NKDIA3/Huhnerklappe/Doku/Rückseite 1.jpg

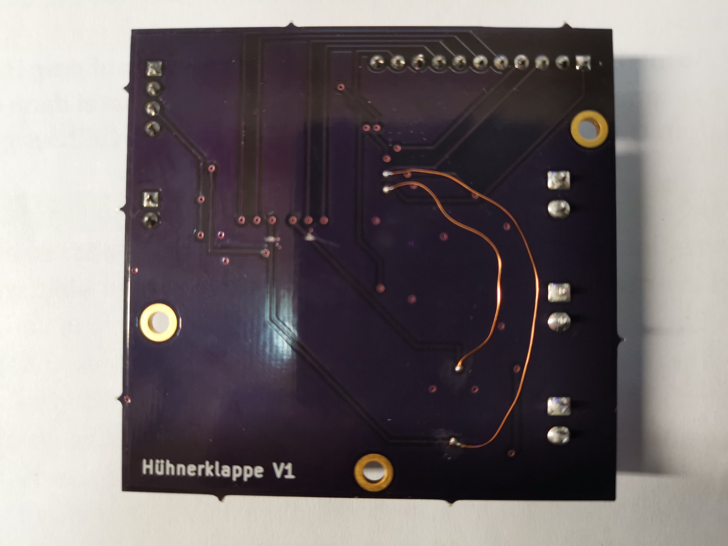
Doku/Rückseite 1.jpg
