NKDIA3/Huhnerklappe/Abschluss/Bilder/Rück layout.png

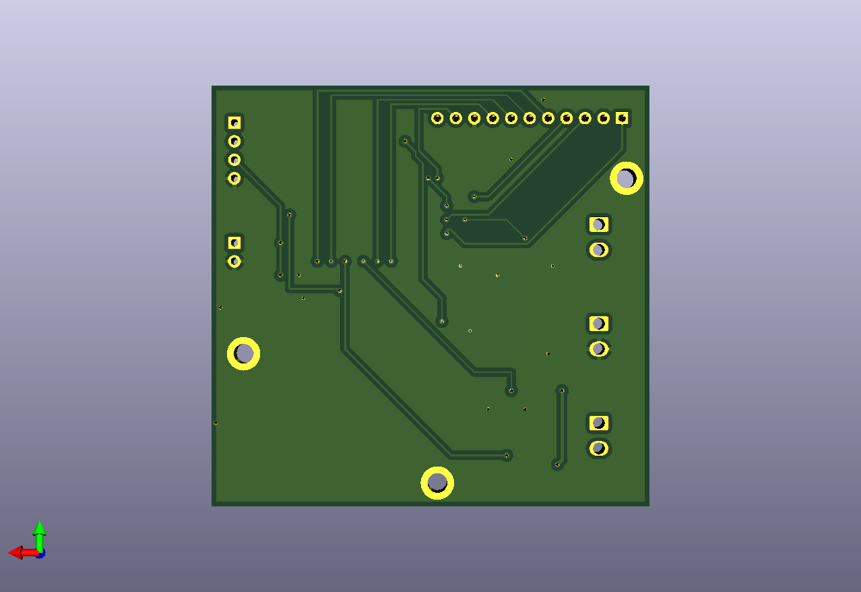
Abschluss/Bilder/Rück layout.png
