NKDIA3/Huhnerklappe/Abschluss/Bilder/Front layout.png

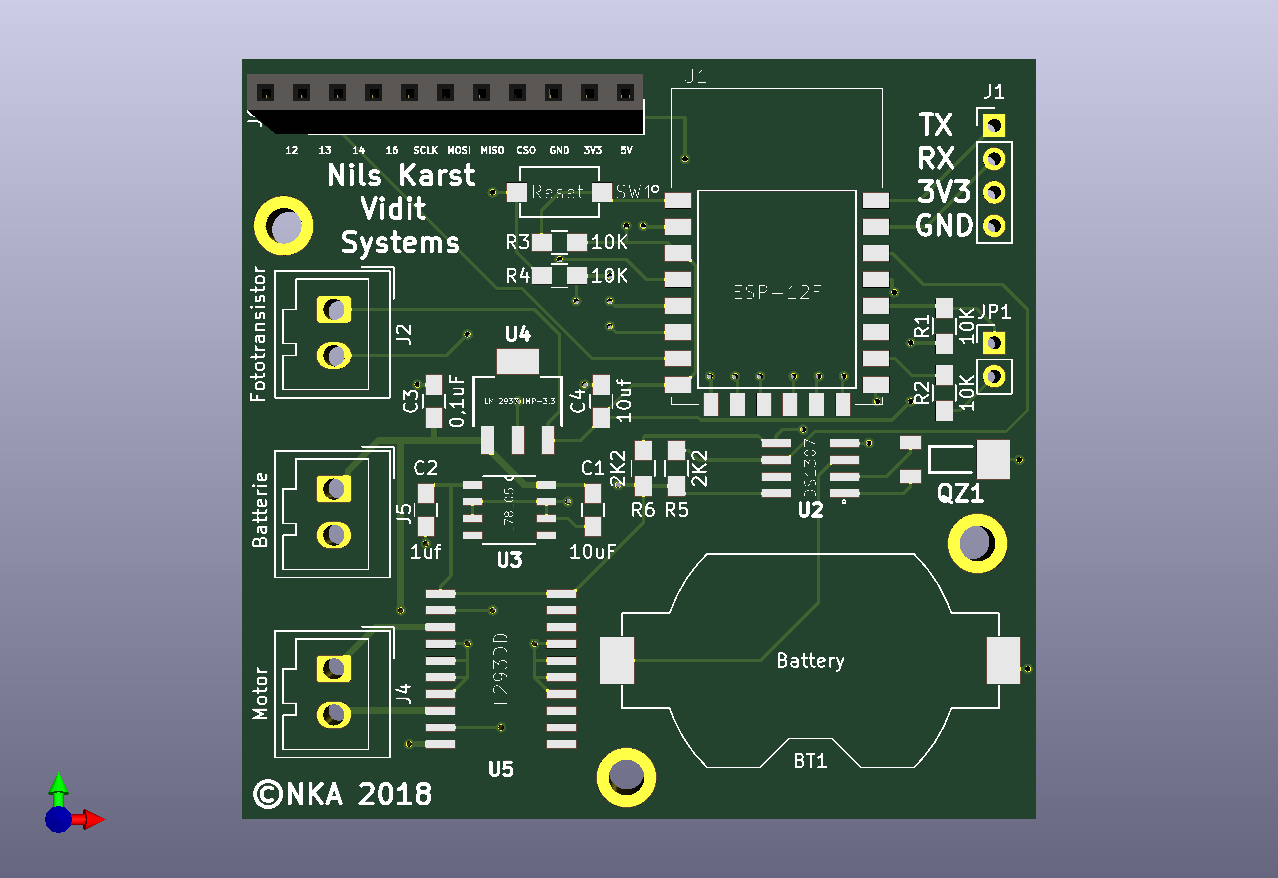
Abschluss/Bilder/Front layout.png
