NKDIA3/Huhnerklappe/Abschluss/Bilder/Frontlayout.png

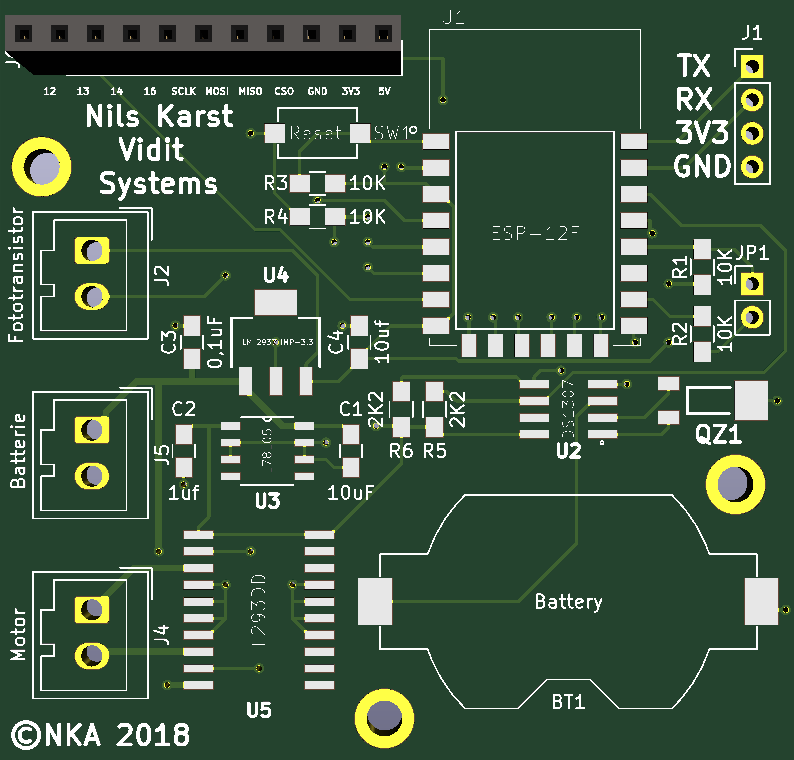
Abschluss/Bilder/Frontlayout.png
