NKDIA3/Huhnerklappe/Abschluss/Bilder/Rücklayout.png

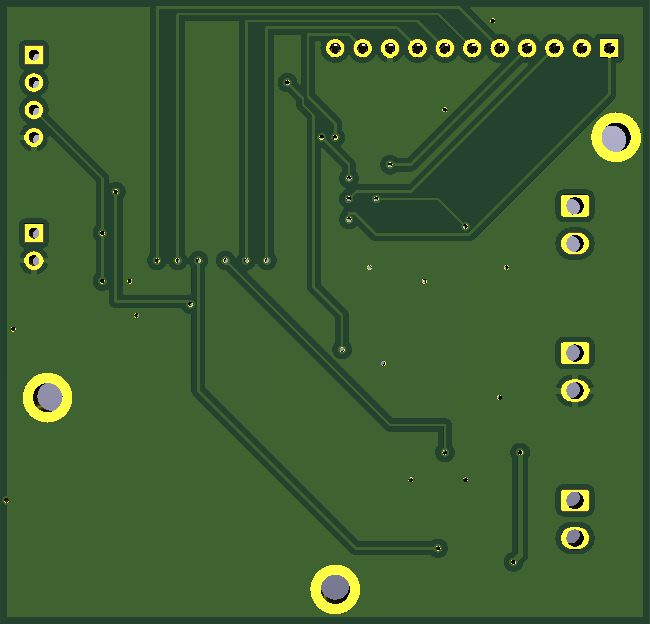
Abschluss/Bilder/Rücklayout.png
