NKDIA3/Huhnerklappe/Doku/Rückseite 2.jpg

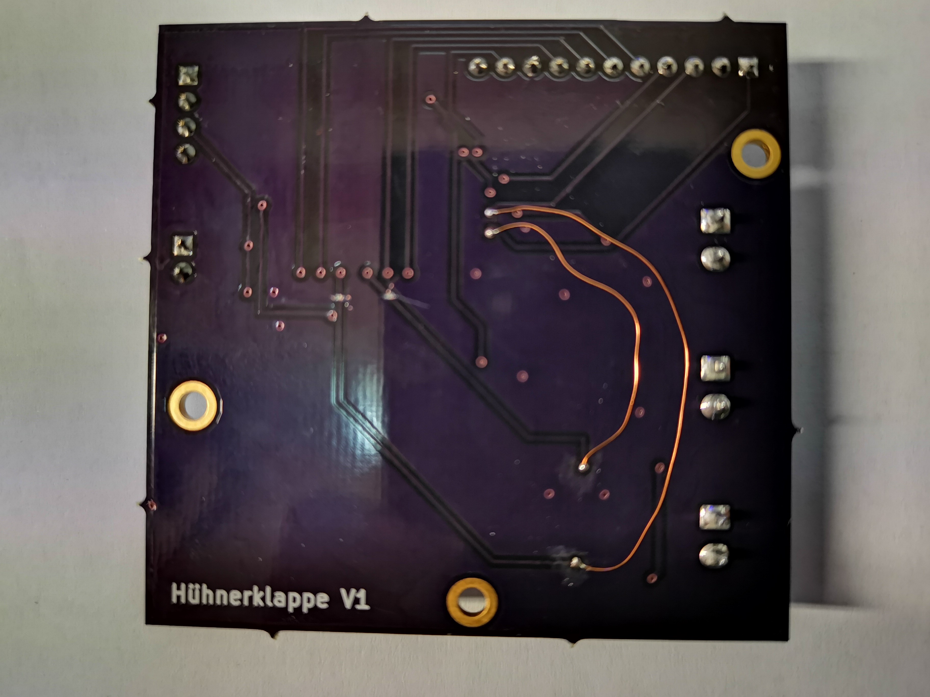
Doku/Rückseite 2.jpg
