NKDIA3/Huhnerklappe/Doku/Rückseite.png

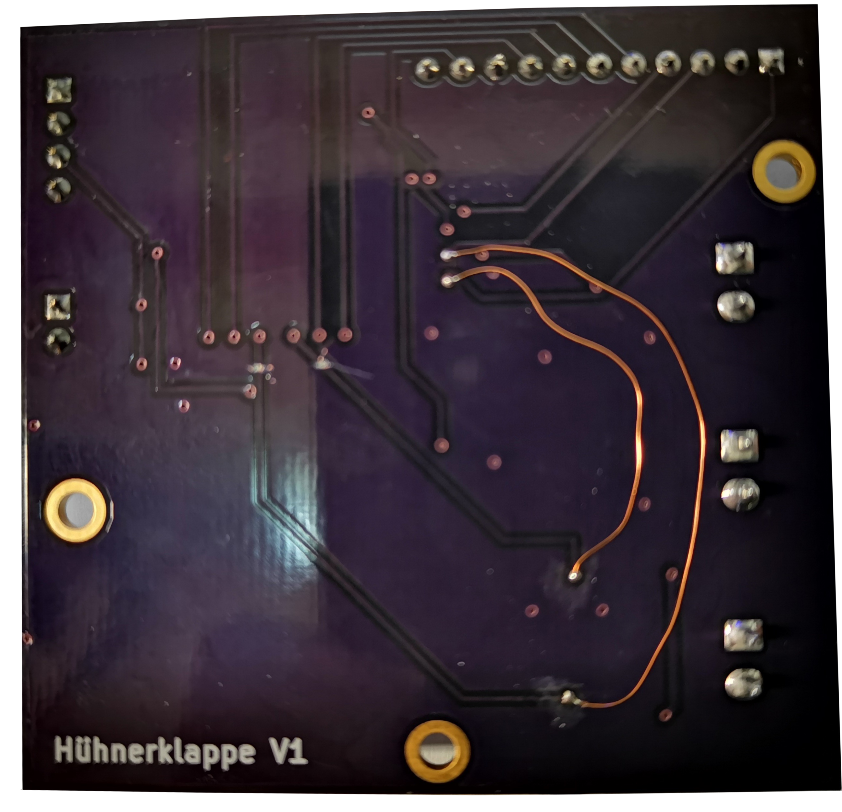
Doku/Rückseite.png
