NKDIA3/Huhnerklappe/Doku/Schaltplan.png

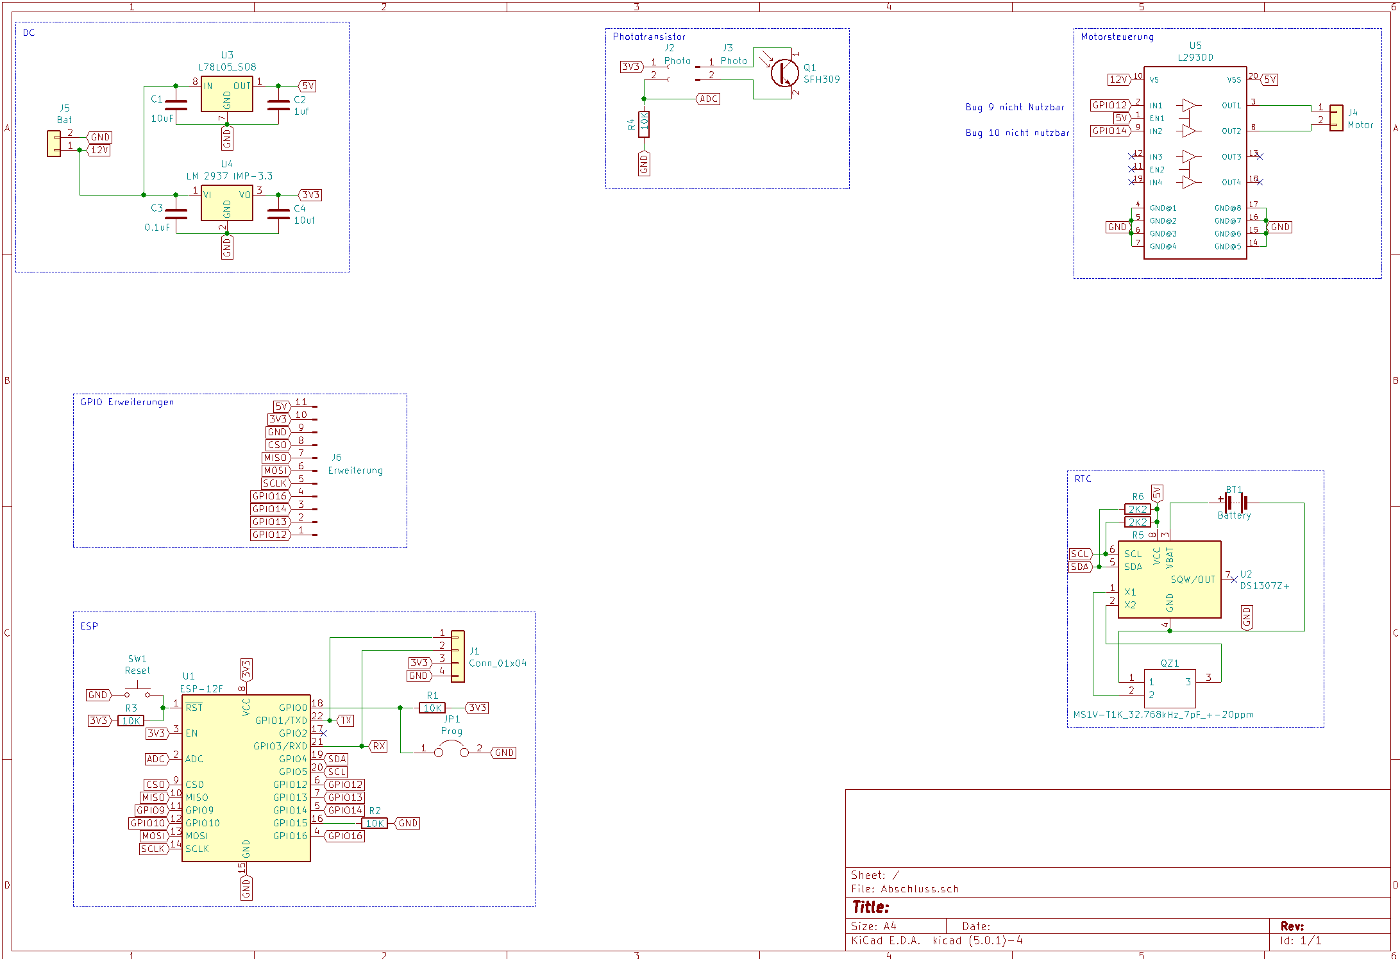
Doku/Schaltplan.png
