NKDIA3/Huhnerklappe/Doku/SchaltplanA3.png

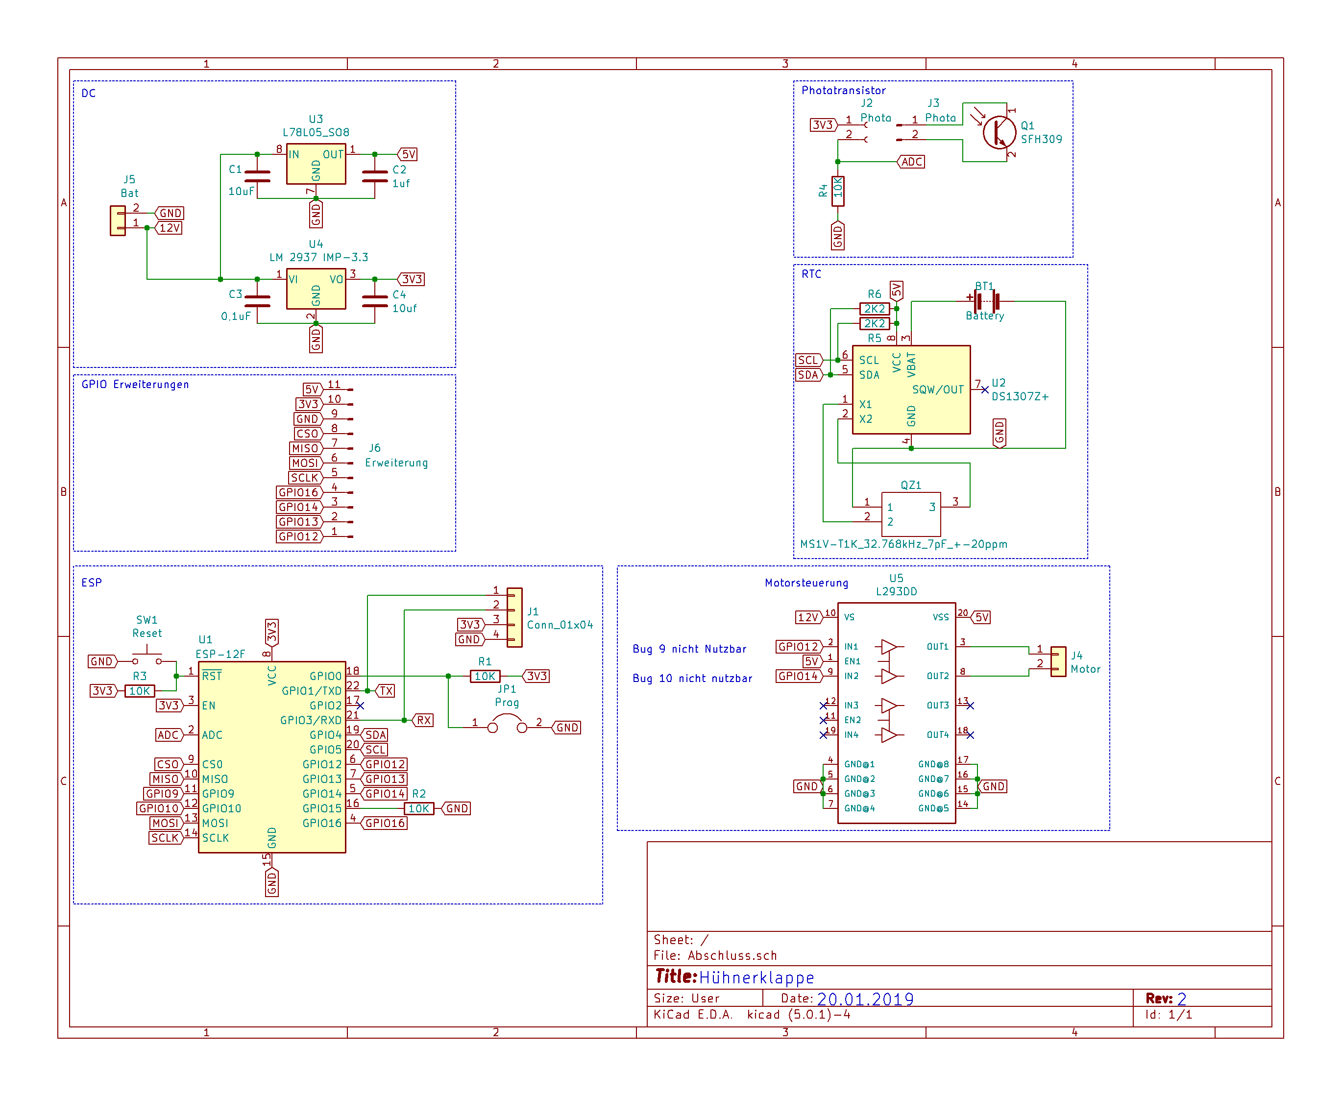
Doku/SchaltplanA3.png
