NKDIA3/Huhnerklappe/Doku/Vorderseite 2.jpg

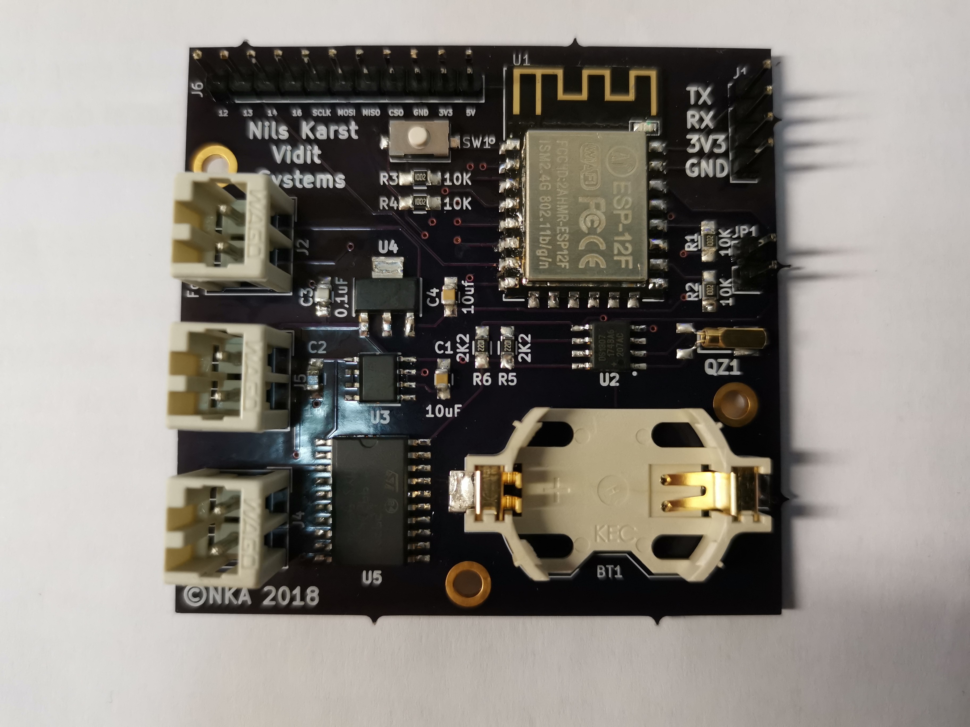
Doku/Vorderseite 2.jpg
