NKDIA3/Huhnerklappe/Abschluss/arduino_micro_shield-master/Schule/Stückliste Binary Clock.xlsx

Stückliste Binary Clock
Pos | Bezeichnung | Typ | Stückz. | Lieferant | Bestellnummer
1 | Bat1 | Batterie | 1 | Farnell | 1823483
2 | U2 | RTC | 1 | Farnell | 2515369
3 | Qz1 | Quarz | 1 | Farnell | 1539359
4 | R1,R2 | 2K2 | 2 | Farnell | 2502700
5 | R3-19 | LED Vorwiderstand 120r | 17 | Farnell | 9339884
6 | D1-6 | LED_Rot | 6 | Reichelt | V 320
7 | D7-17 | LED_Gelb | 11 | Reichelt | V 323
8 | U1 | Arduino | 1 | Reichelt | ARDUINO MICRO
