NKDIA3/Huhnerklappe/TODO Vidit Dienstag.txt

Platine löten 
Bilder 
In Doku 
Doku drucken und abheften
Datenblätter drucken
