NKDIA3/Huhnerklappe/Abschluss/arduino_micro_shield-master/Schule - Kopie/Schaltplanm.pdf

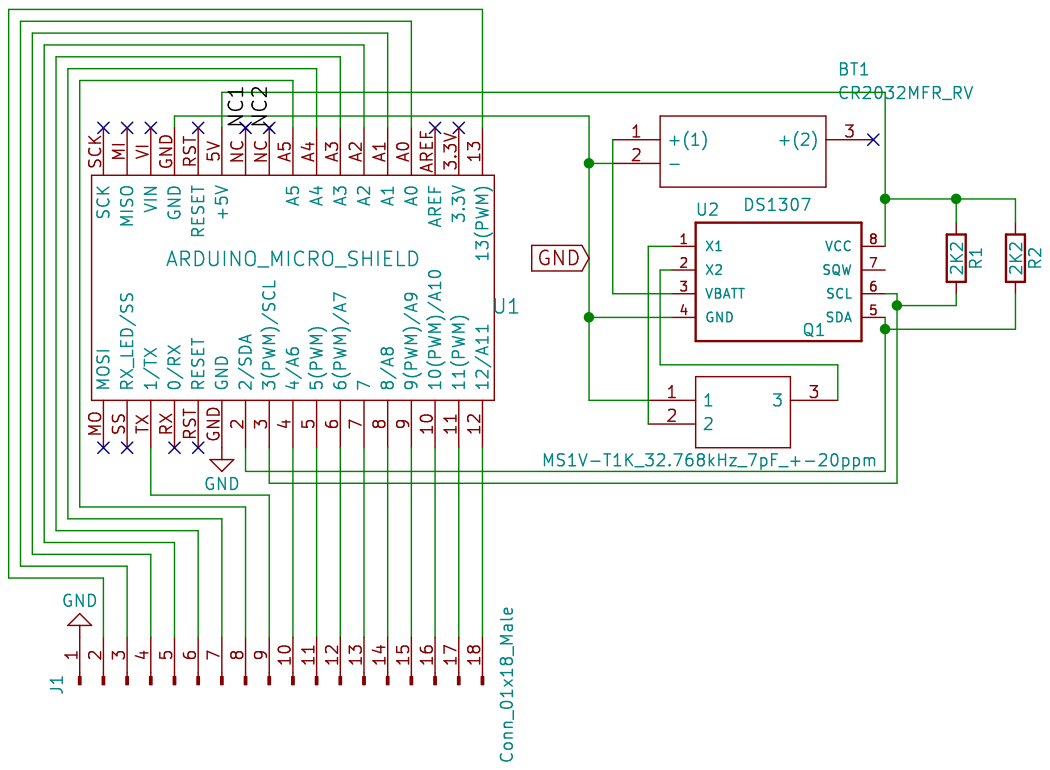
[picture p26: page 1]
