NKDIA3/Huhnerklappe/(list of files, drawings)

Other design files:
Doku/Hühnerklappe.spl7
