NKDIA3/Huhnerklappe/Abschluss/arduino_micro_shield-master/Schule - Kopie/Binary clock 1.kicad_pcb

## KiCad design Abschluss/arduino_micro_shield-master/Schule - Kopie/Binary clock 1.kicad_pcb (2019-01-14, an earlier design)

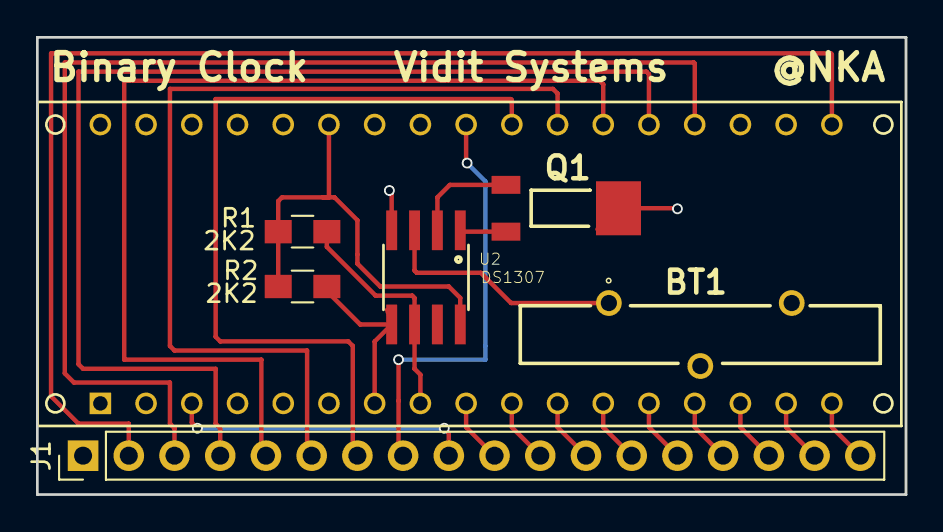
[picture p27: board Binary clock 1.kicad_pcb from above]

Board: 2 copper layers, 48.3 x 25.4 mm, 6 parts (0 on the bottom side), 7 nets.

Parts:
BT1: CR2032MFR-RV
J1: Conn_01x18_Male; Pin_Header_Straight_1x18_Pitch2.54mm
Q1: MS1V-T1K32
R1, R2: 2K2; R_0805_HandSoldering
U2: DS1307; SO08

Connections:
GND: BT1.2, J1.1, Q1.1, U2.4
unnamed: BT1.1, U2.3
unnamed: Q1.2, U2.1
unnamed: Q1.3, U2.2
unnamed: R1.1, R2.1, U2.8
unnamed: R1.2, U2.6
unnamed: R2.2, U2.5
