NKDIA3/Huhnerklappe/Abschluss/Abschluss/Abschluss.kicad_pcb

## KiCad design Abschluss/Abschluss/Abschluss.kicad_pcb (2019-01-14)

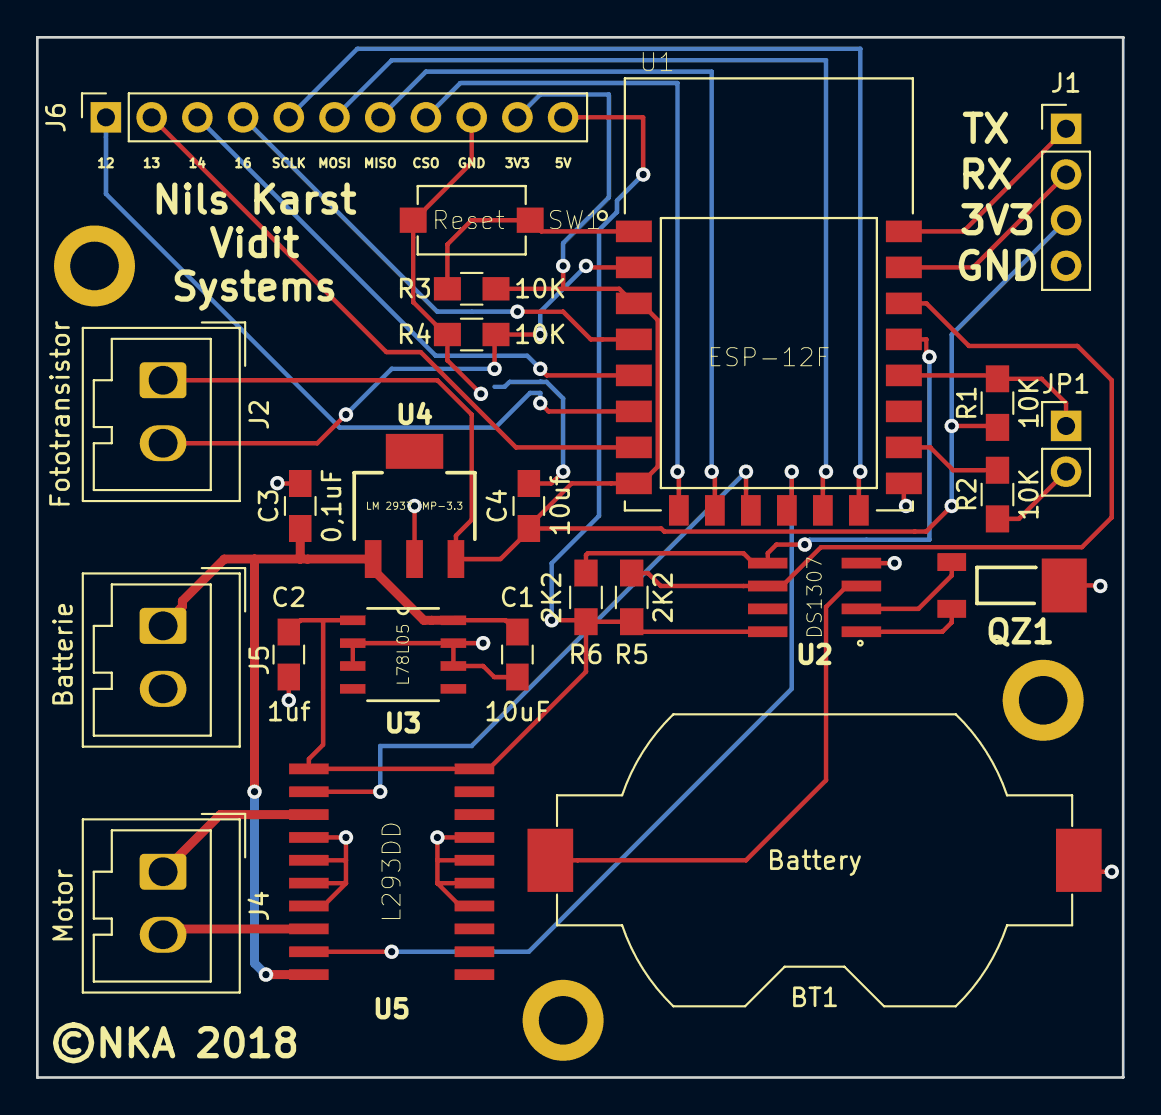
[picture p28: board Abschluss.kicad_pcb from above]

Board: 2 copper layers, 60.3 x 57.8 mm, 24 parts (0 on the bottom side), 27 nets.

Parts:
BT1: Battery; Keystone_1058_1x2032-CoinCell
C1: 10uF; C_0805_HandSoldering
C2: 1uf; C_0805_HandSoldering
C3: 0,1uF; C_0805_HandSoldering
C4: 10uf; C_0805_HandSoldering
J1: Conn_01x04; Pin_Header_Straight_1x04_Pitch2.54mm
J2: Fototransistor; Wago_734-132_1x02_P3.50mm_Vertical
J4: Motor; Wago_734-132_1x02_P3.50mm_Vertical
J5: Batterie; Wago_734-132_1x02_P3.50mm_Vertical
J6: Erweiterung; PinSocket_1x11_P2.54mm_Vertical
JP1: Prog; Pin_Header_Straight_1x02_Pitch2.54mm
QZ1: MS1V-T1K32
R1, R2, R3, R4: 10K; R_0805_HandSoldering
R5, R6: 2K2; R_0805_HandSoldering
SW1: Reset; 434111025826
U1: ESP-12F; XCVR_ESP8266-12E%2fESP-12E
U2: DS1307; SO08
U3: L78L05; SOIC127P600X175-8N
U4: LM 2937 IMP-3.3; SOT230P700X180-4N
U5: L293DD; SO20

Connections:
3V3: C4.1, J1.3, J2.1, J6.10, R1.1, R3.2, U1.3, U1.8, U4.3
5V: C2.1, J6.11, R5.1, R6.1, U2.8, U3.1, U5.1, U5.20
12V: C1.1, C3.1, J5.1, U3.8, U4.1, U5.10
ADC: J2.2, R4.1, U1.2
CSO: J6.8, U1.9
GND: BT1.2, C1.2, C2.2, C3.2, C4.2, J1.4, J5.2, J6.9, JP1.2, QZ1.1, R2.1, R4.2, SW1.1, U1.15, U2.4, U3.2, U3.3, U3.6, U3.7, U4.2, U5.4, U5.5, U5.6, U5.7, U5.14, U5.15, U5.16, U5.17
GPIO9: U1.11, U5.2
GPIO10: U1.12, U5.9
GPIO12: J6.1, U1.6
GPIO13: J6.2, U1.7
GPIO14: J6.3, U1.5
GPIO16: J6.4, U1.4
MISO: J6.7, U1.10
MOSI: J6.6, U1.13
unnamed: BT1.1, U2.3
unnamed: J4.1, U5.3
unnamed: J4.2, U5.8
unnamed: JP1.1, R1.2, U1.18
unnamed: QZ1.2, U2.1
unnamed: QZ1.3, U2.2
unnamed: R2.2, U1.16
unnamed: R3.1, SW1.2, U1.1
RX: J1.2, U1.21
SCL: R5.2, U1.20, U2.6
SCLK: J6.5, U1.14
SDA: R6.2, U1.19, U2.5
TX: J1.1, U1.22
