NKDIA3/Huhnerklappe/Abschluss/arduino_micro_shield-master/Schule - Kopie/namenlos1.kicad_pcb

## KiCad design Abschluss/arduino_micro_shield-master/Schule - Kopie/namenlos1.kicad_pcb (2019-01-14, an earlier design)

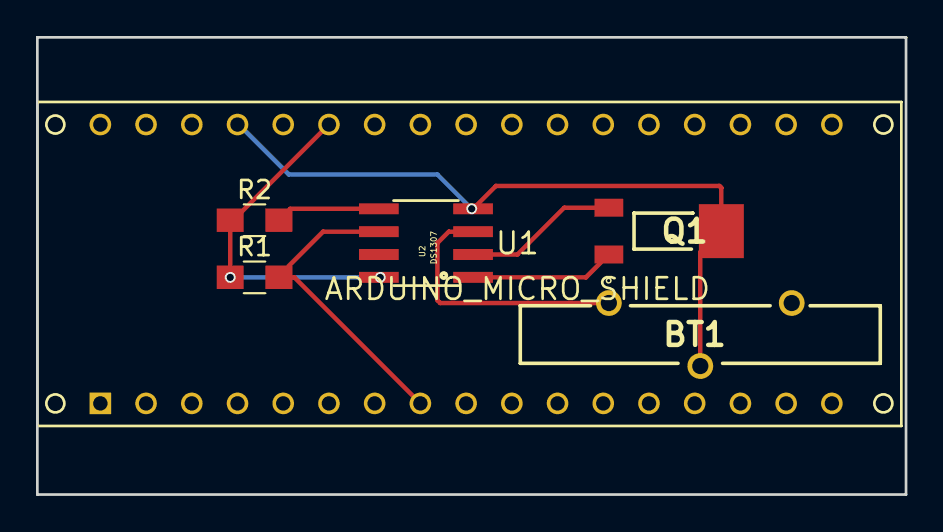
[picture p29: board namenlos1.kicad_pcb from above]

Board: 2 copper layers, 48.3 x 25.4 mm, 6 parts (0 on the bottom side), 7 nets.

Parts:
BT1: CR2032MFR_RV; CR2032MFR-RV
Q1: MS1V-T1K_32.768kHz_7pF_+-20ppm; MS1V-T1K32
R1, R2: 2K2; R_0805_HandSoldering
U1: ARDUINO_MICRO_SHIELD
U2: DS1307; SO08

Connections:
unnamed: BT1.1, BT1.3, U2.3
unnamed: BT1.2, Q1.1, U1.GND, U2.4
unnamed: Q1.2, U2.1
unnamed: Q1.3, U2.2
unnamed: R1.1, R2.1, U1.5V, U2.8
unnamed: R1.2, U1.3, U2.6
unnamed: R2.2, U1.2, U2.5
