NKDIA3/Huhnerklappe/(commit log)

2019-01-09 Update WIP.ino
    Alle Funktionen enthalten und getestet.
    ---
2019-01-14 Added Kicad
    [Abschluss.kicad_pcb, Abschluss.sch, Binary clock 1.kicad_pcb, Binary clock 1.sch, Stückliste Binary Clock.xlsx, namenlos1.kicad_pcb, namenlos2.kicad_pcb]
2019-01-14 Weitere Ergänzungen
    [_saved_Abschluss.sch]
2019-01-14 Schaltplan optische anpassung
    [Abschluss.sch, _saved_Abschluss.sch]
2019-01-15 Added Doku
    [Hühnerklappe.spl7]
2019-01-15 Rechtschreibprüfung
    [Abschluss.sch]
2019-01-19 Bugfix Abend &
    && durch ||
    [WIP.ino]
