NKDIA3/Huhnerklappe/(notices)

Notices in the files:
Abschluss/Abschluss/Abschluss.kicad_pcb:
©NKA 2018
